ControlandoEletrons/TigardBR/TigardBR/3. Assets/1745753068074.jpg

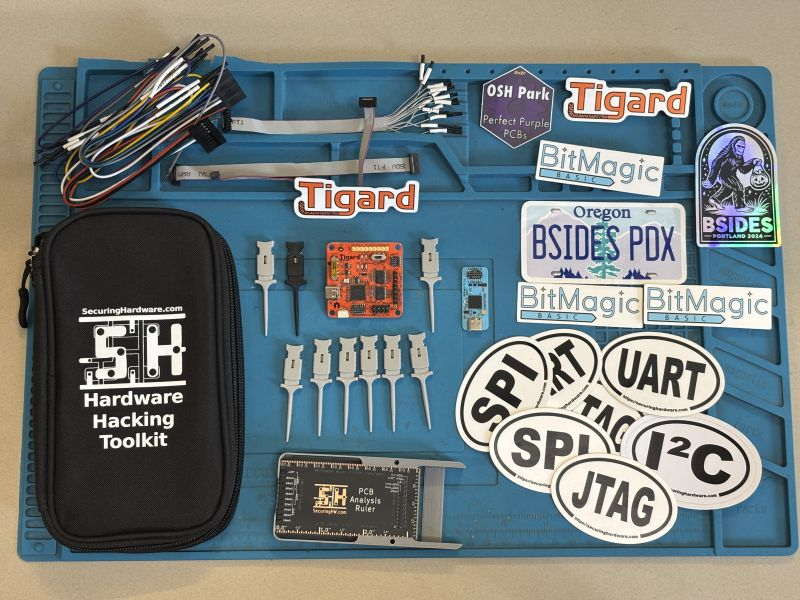
TigardBR/3. Assets/1745753068074.jpg
