ControlandoEletrons/TigardBR/TigardBR/3. Assets/Gi0Y8tjaMAABM5-.jpg

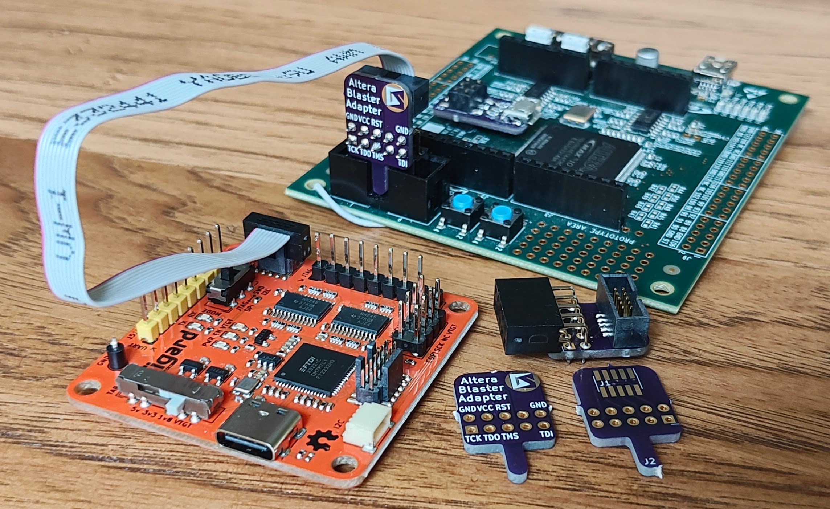
TigardBR/3. Assets/Gi0Y8tjaMAABM5-.jpg
