ControlandoEletrons/TigardBR/TigardBR/3. Assets/signaloid-external-illustration-Tigard-connection-diagram-withCR.png

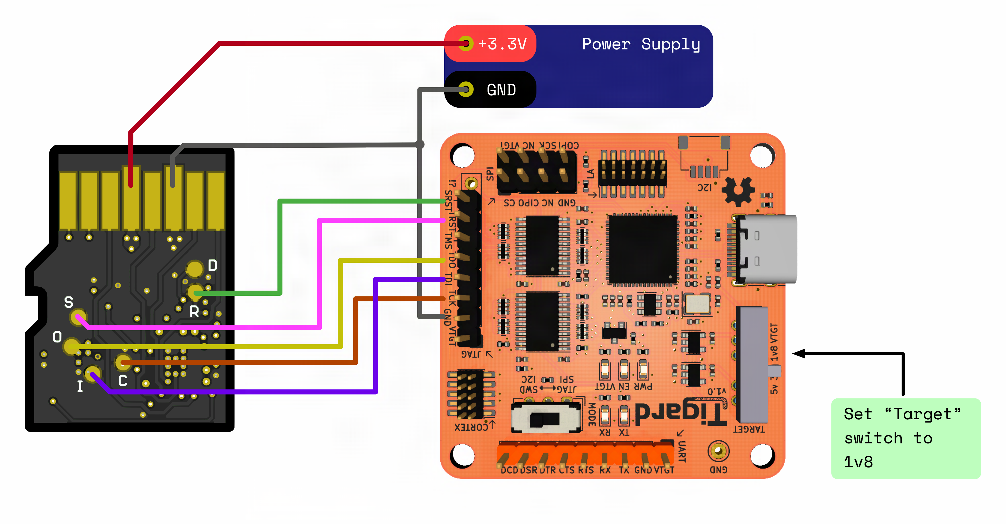
TigardBR/3. Assets/signaloid-external-illustration-Tigard-connection-diagram-withCR.png
