ControlandoEletrons/TigardBR/TigardBR/3. Assets/tigard-back.png

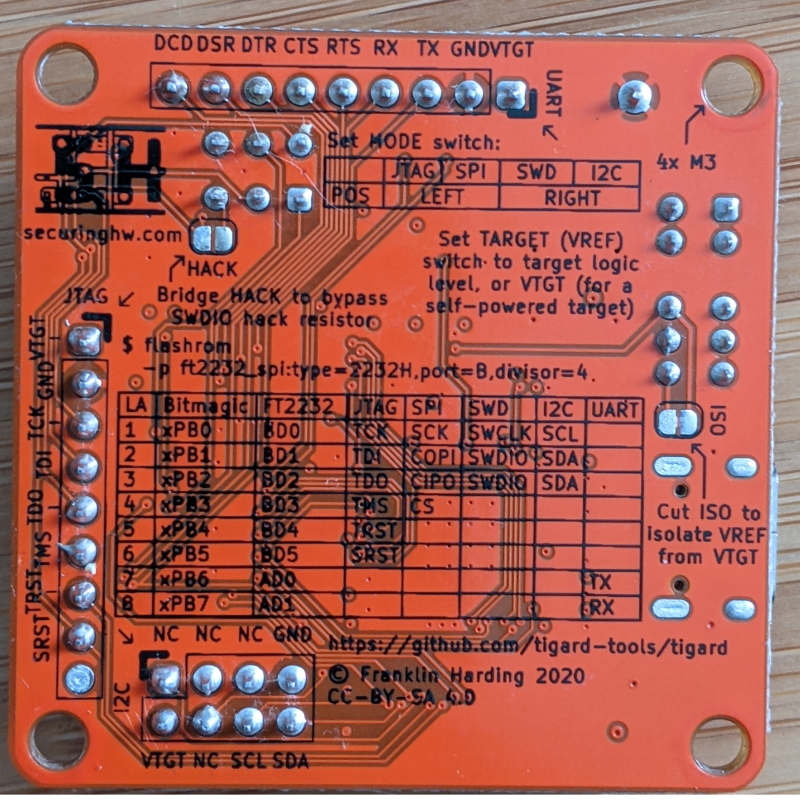
TigardBR/3. Assets/tigard-back.png
