ControlandoEletrons/TigardBR/TigardBR/3. Assets/Tigard-case-141341_002a.jpg

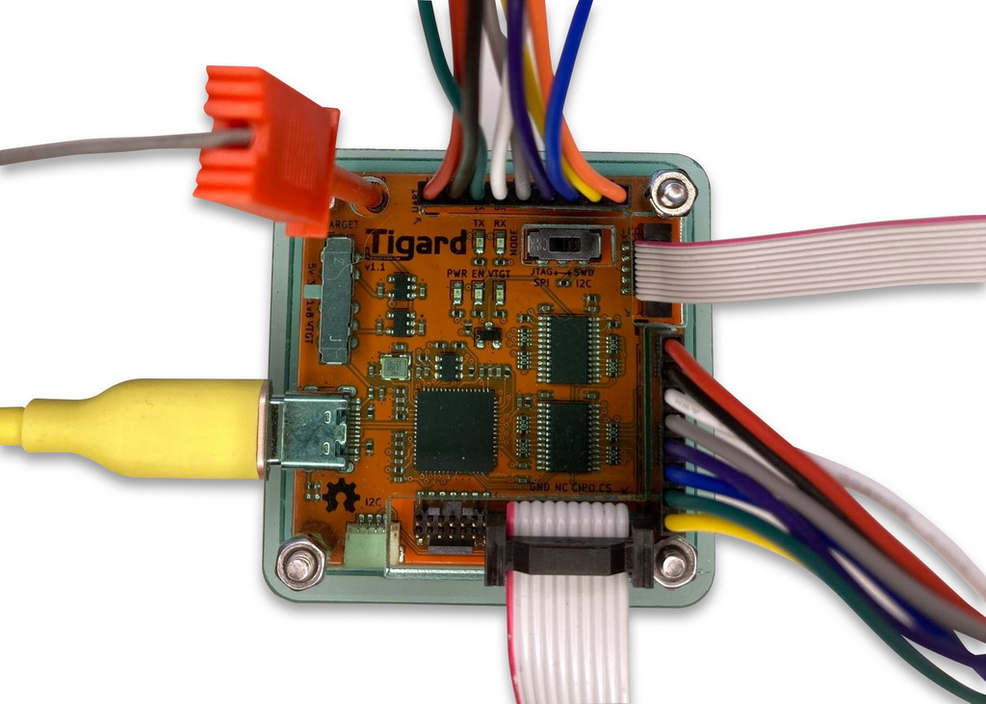
TigardBR/3. Assets/Tigard-case-141341_002a.jpg
