ControlandoEletrons/TigardBR/TigardBR/3. Assets/tigard-front.png

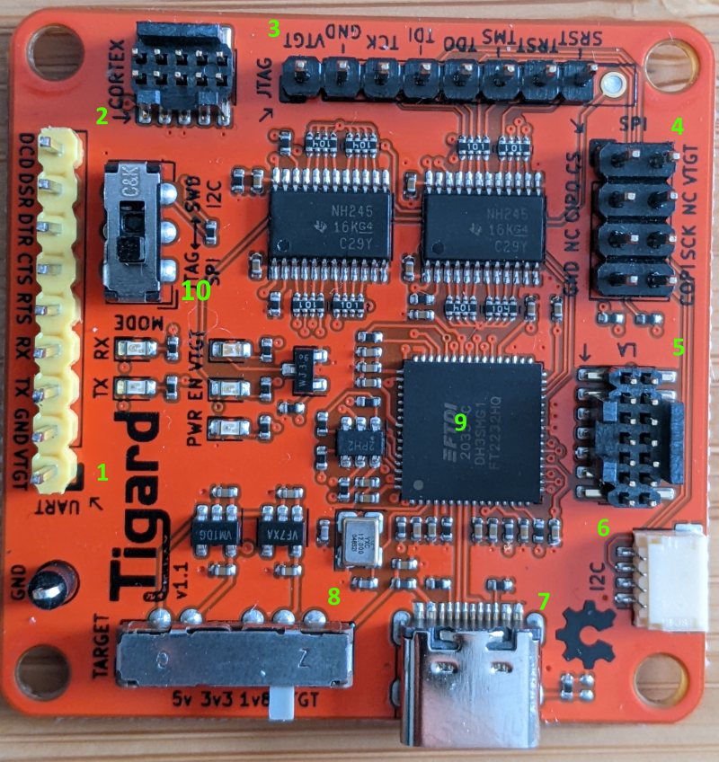
TigardBR/3. Assets/tigard-front.png
