ControlandoEletrons/TigardBR/Tigard/2. Datasheets/Slider Switch/3D Model/SSSS224100.STEP

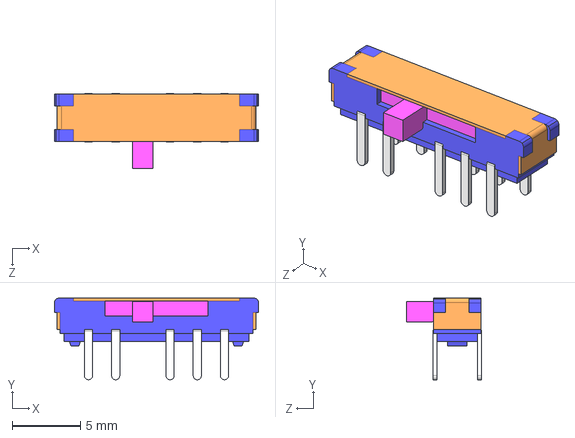
[picture p8: CAD file, 2026-01-16]
Tigard/2. Datasheets/Slider Switch/3D Model/SSSS224100.STEP
15.0 x 6.00 x 5.55 mm
