ControlandoEletrons/TigardBR/Tigard/0. Project/tigard.pdf

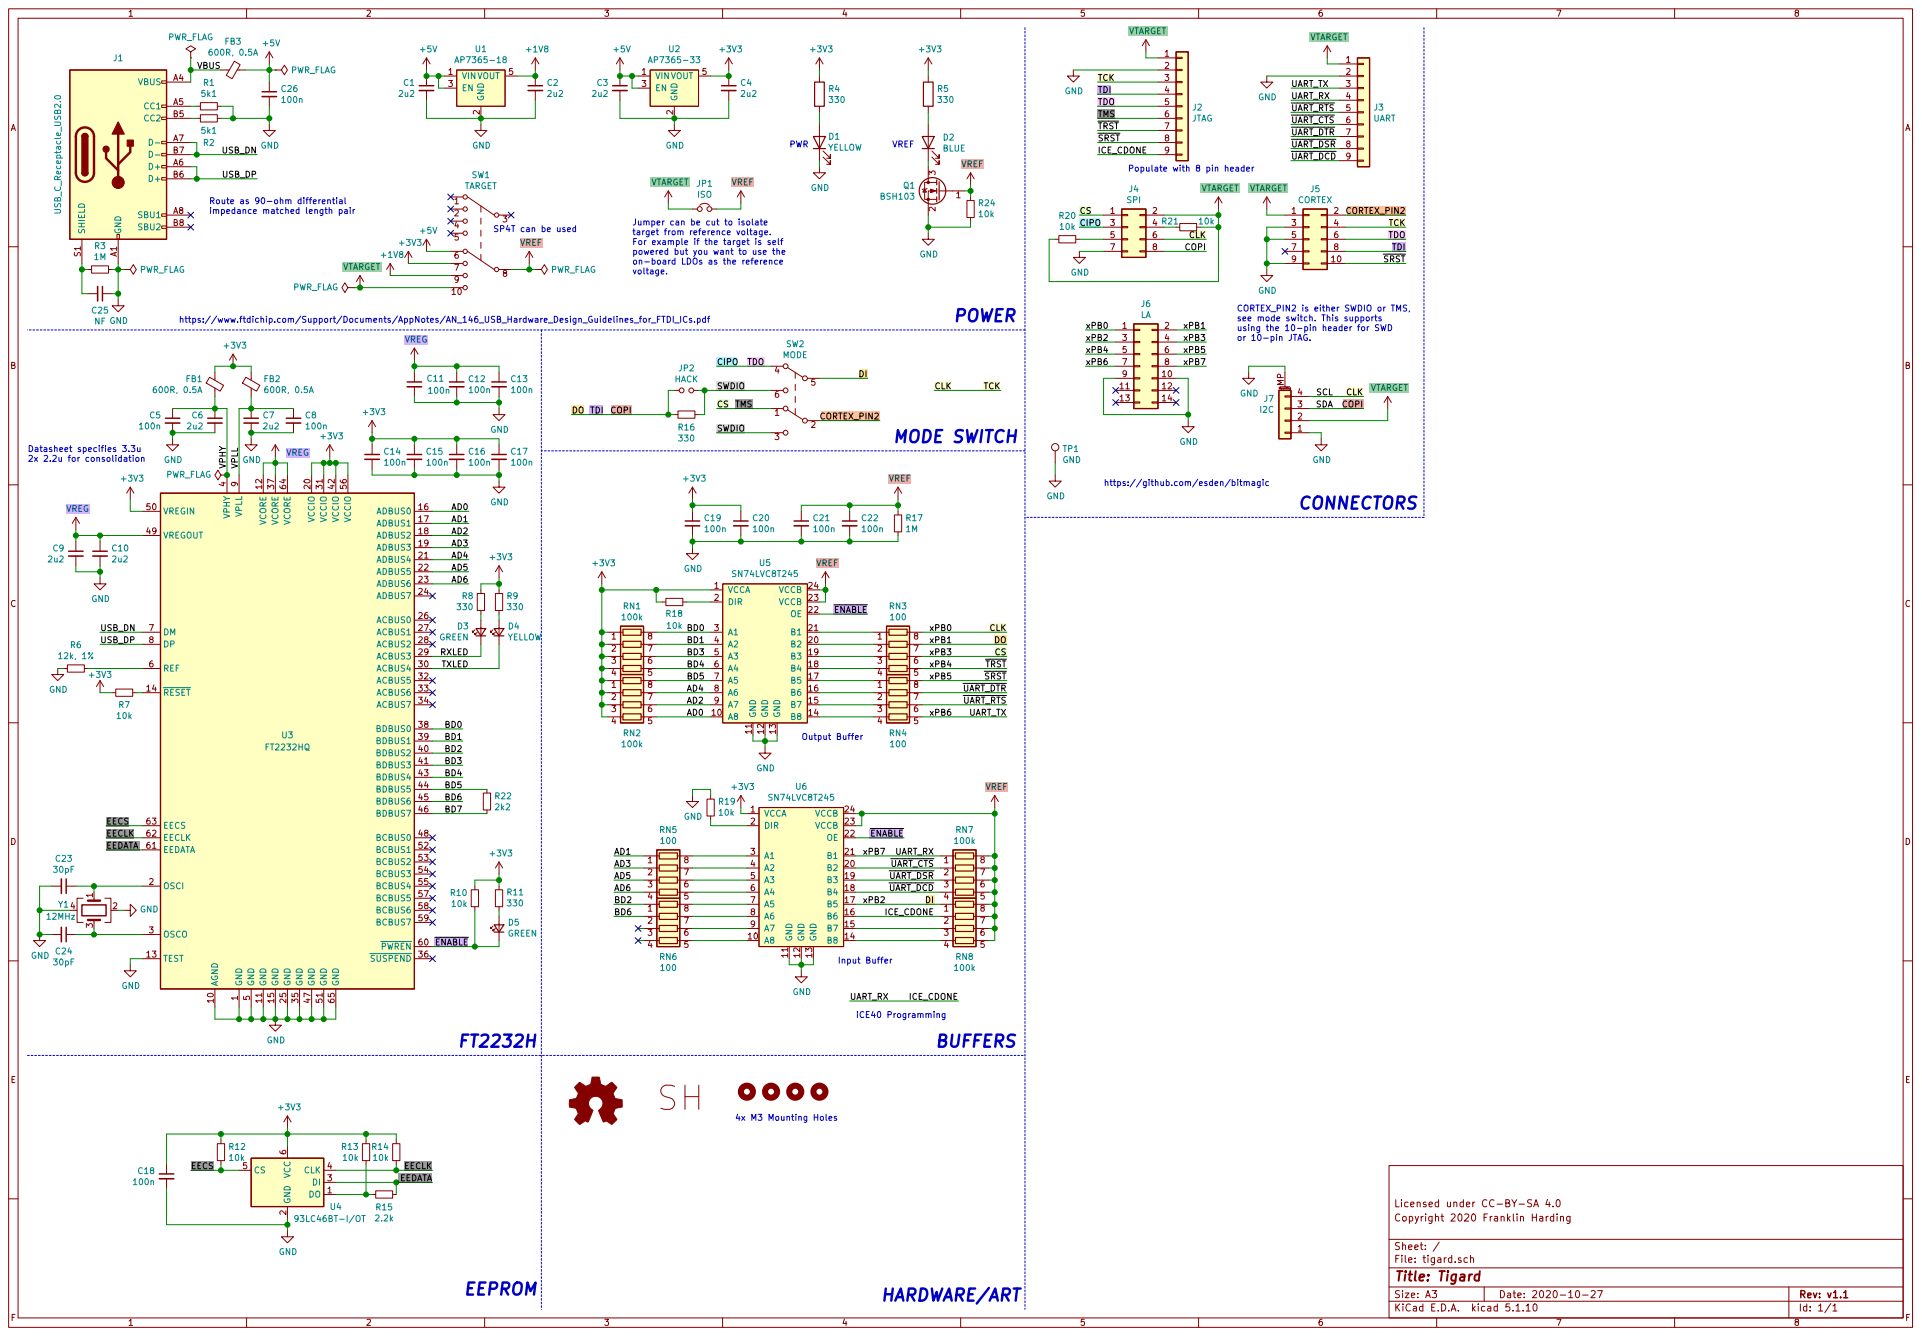
[picture p9: page 1]

Populate with 8 pin header

SP4T can be used Route as 90-ohm differential
impedance matched length pair
10k GND

Jumper can be cut to isolate
target from reference voltage.
For example if the target is self
powered but you want to use the
on-board LDOs as the reference

5 | 6 TDO
7 | 8 TDI SRST

GND
CORTEX_PIN2 is either SWDIO or TMS, see mode switch. This supports

https://www.ftdichip.com/Support/Documents/AppNotes/AN_146_USB_Hardware_Design_Guidelines_for_FTDI_ICs.pdf

using the 10-pin header for SWD
or 10-pin JTAG.

https://github.com/esden/bitmagic

1 AGND 10 GND 11 VCORE 12 TEST 13 RESET 14 GND 15 ADBUS0 16 ADBUS1 17 ADBUS2 18 ADBUS3 19 OSCI 2 VCCIO 20 ADBUS4 21 ADBUS5 22 ADBUS6 23 ADBUS7 24 GND 25 ACBUS0 26 ACBUS1 27 ACBUS2 28 ACBUS3 29 OSCO 3 ACBUS4 30 VCCIO 31 ACBUS5 32 ACBUS6 33 ACBUS7 34 GND 35 SUSPEND 36 VCORE 37 BDBUS0 38 BDBUS1 39 VPHY

4 BDBUS2 40 BDBUS3 41 VCCIO 42 BDBUS4 43 BDBUS5 44 BDBUS6 45 BDBUS7 46 GND 47 BCBUS0 48 VREGOUT 49 GND

5 VREGIN 50 GND 51 BCBUS1 52 BCBUS2 53 BCBUS3 54 BCBUS4 55 VCCIO 56 BCBUS5 57 BCBUS6 58 BCBUS7 59 REF 6 PWREN 60 EEDATA 61 EECLK 62 EECS 63 VCORE 64 GND 65 DM 7 DP 8 VPLL

2 DI 3 CLK 4 CS 5 VCC

Licensed under CC-BY-SA 4.0
File: tigard.sch Sheet: / Copyright 2020 Franklin Harding
