ControlandoEletrons/TigardBR/TigardBR/0. Project/TigardBR.sch

## EAGLE design TigardBR/0. Project/TigardBR.sch (2026-01-29)

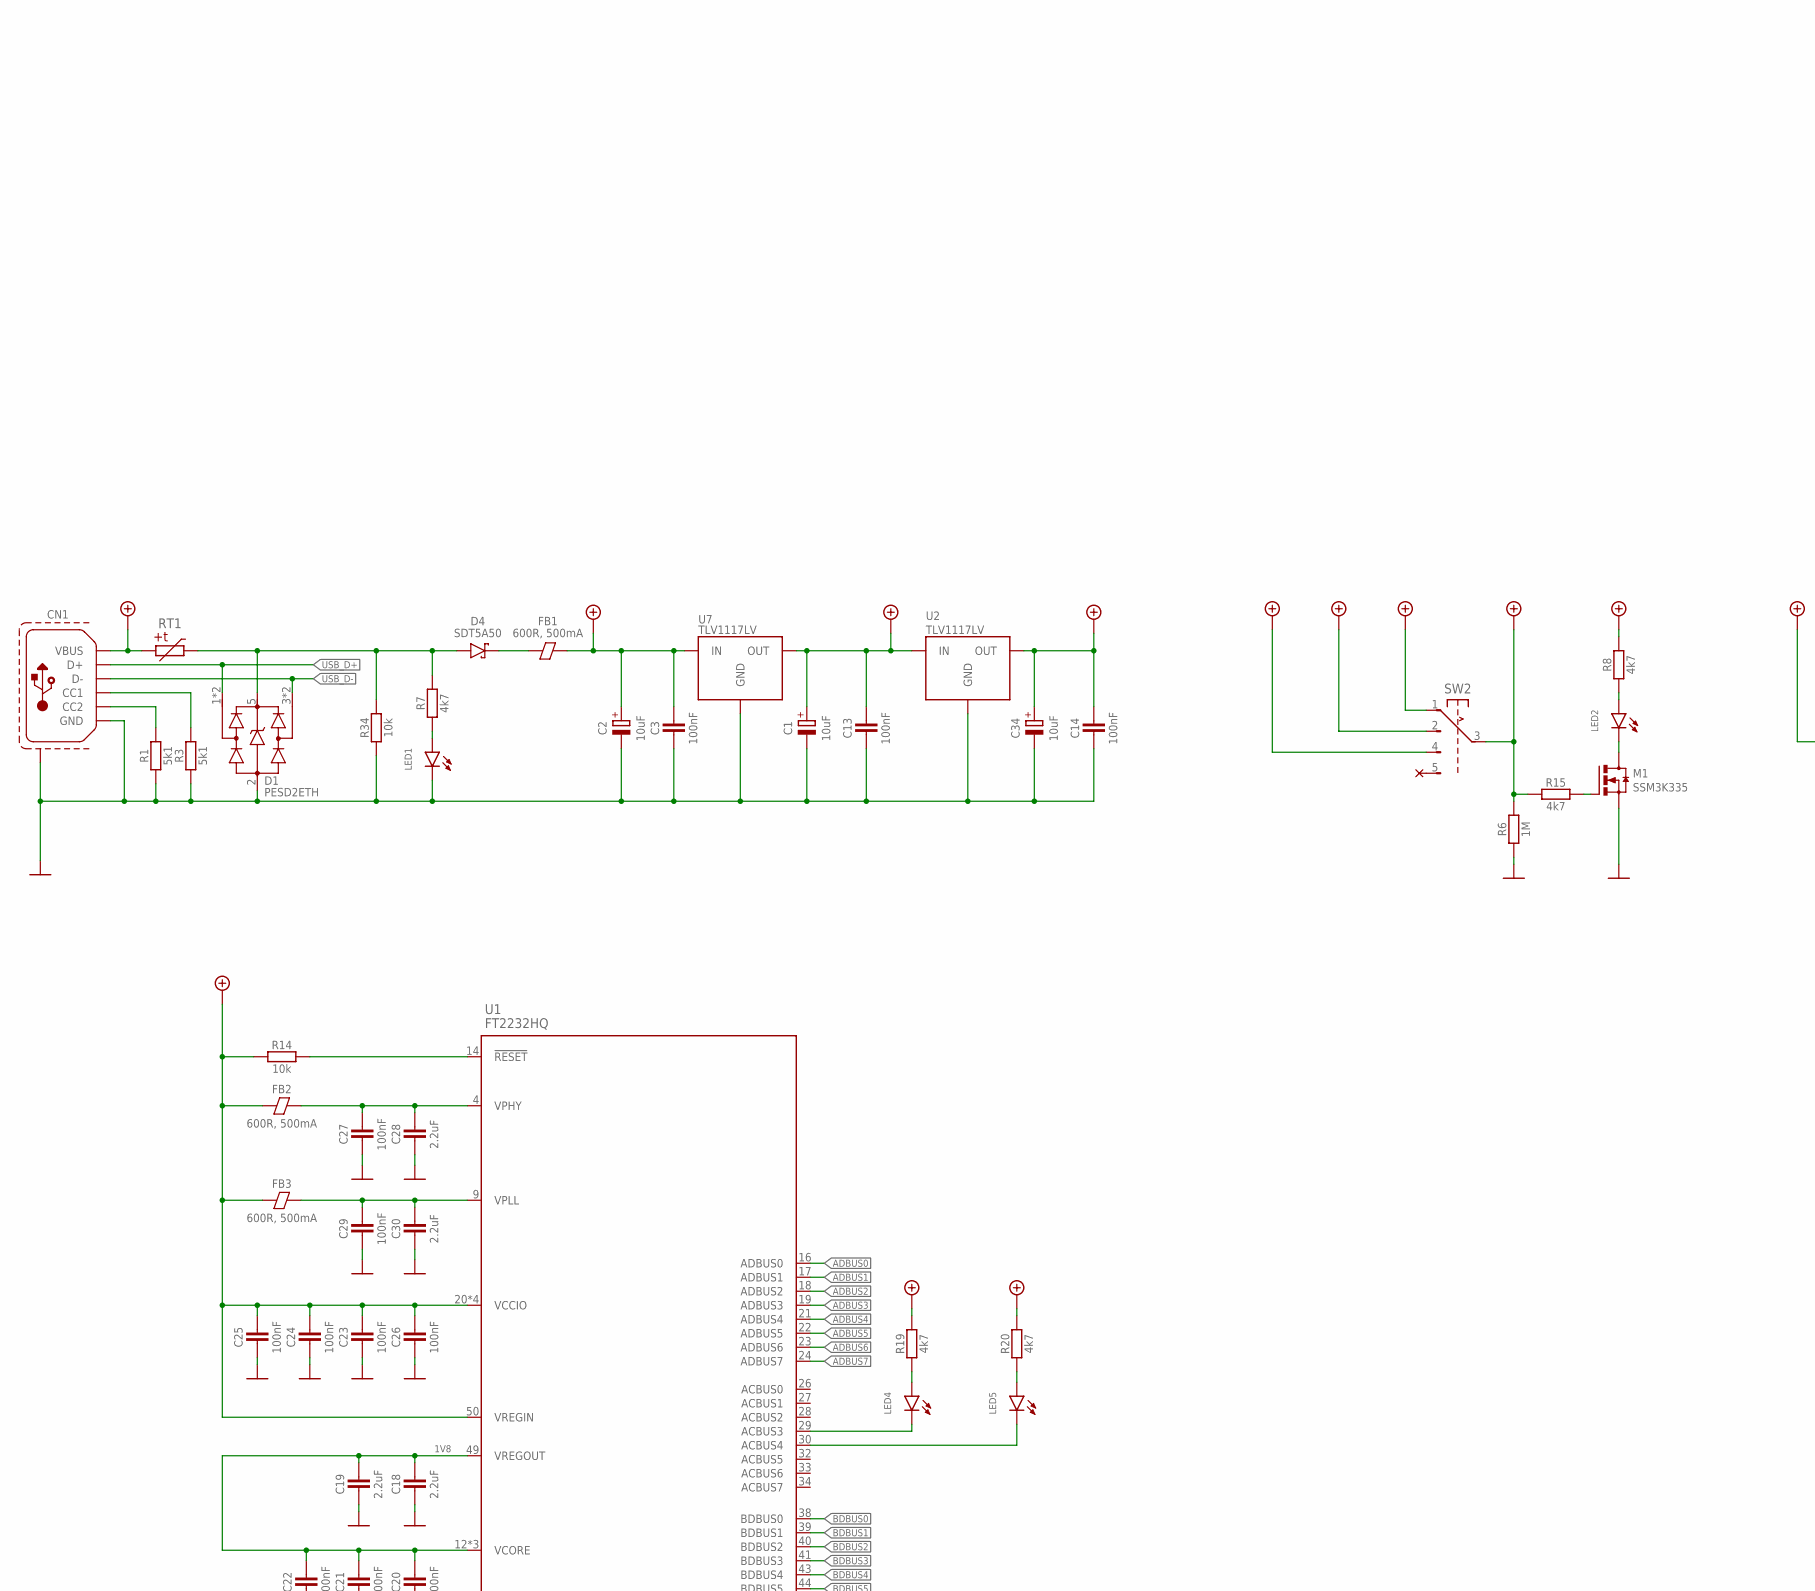
[picture p13: schematic TigardBR.sch, part in row 1, column 1]

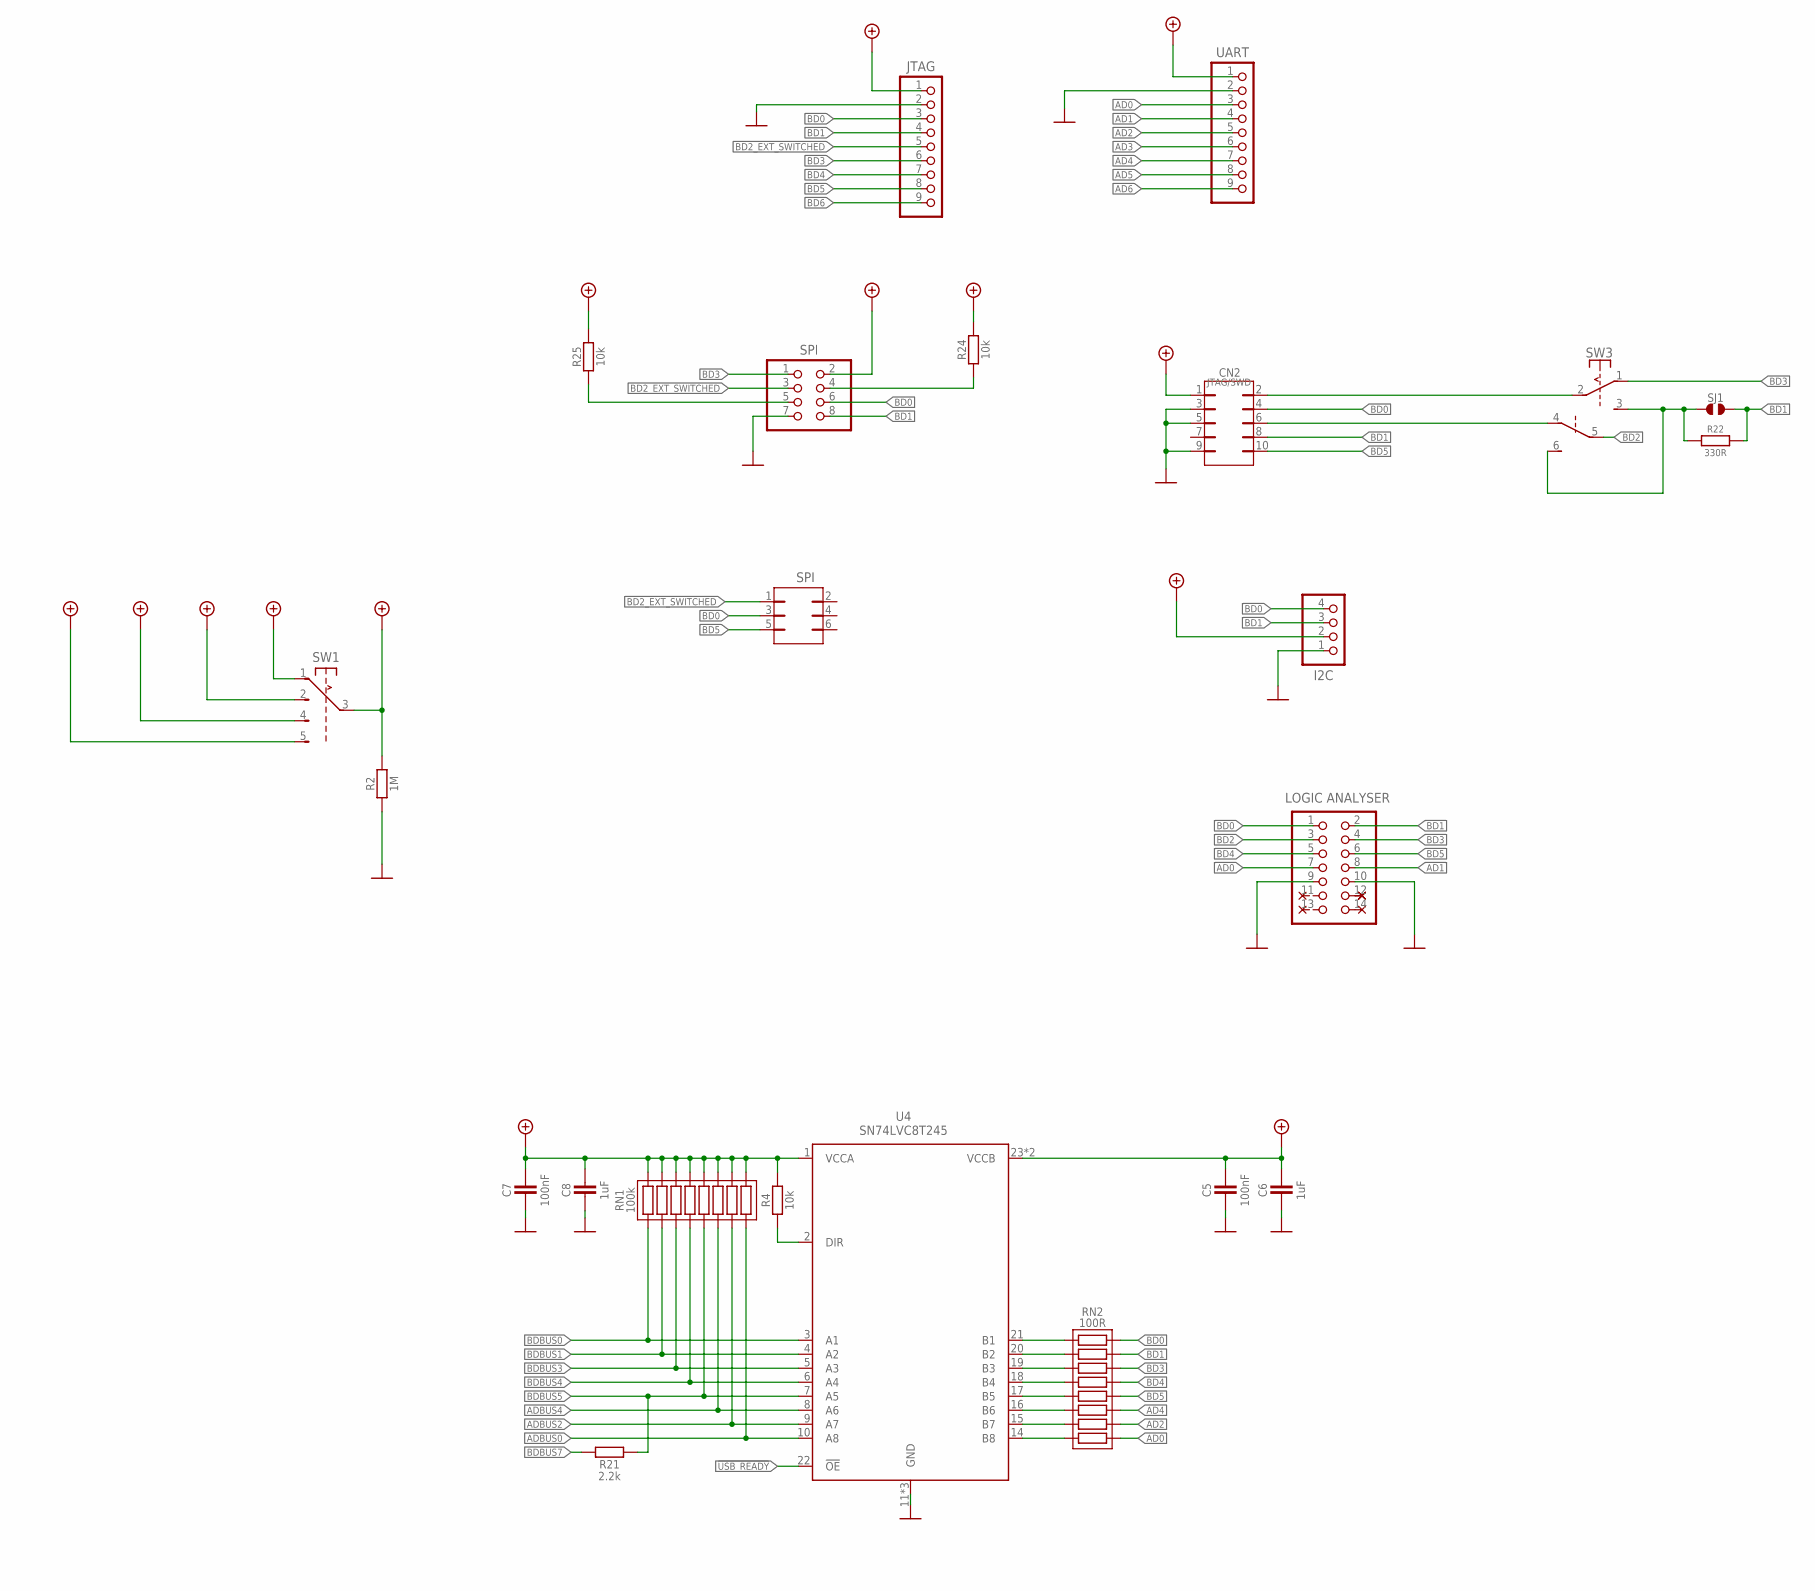
[picture p14: schematic TigardBR.sch, part in row 1, column 2]

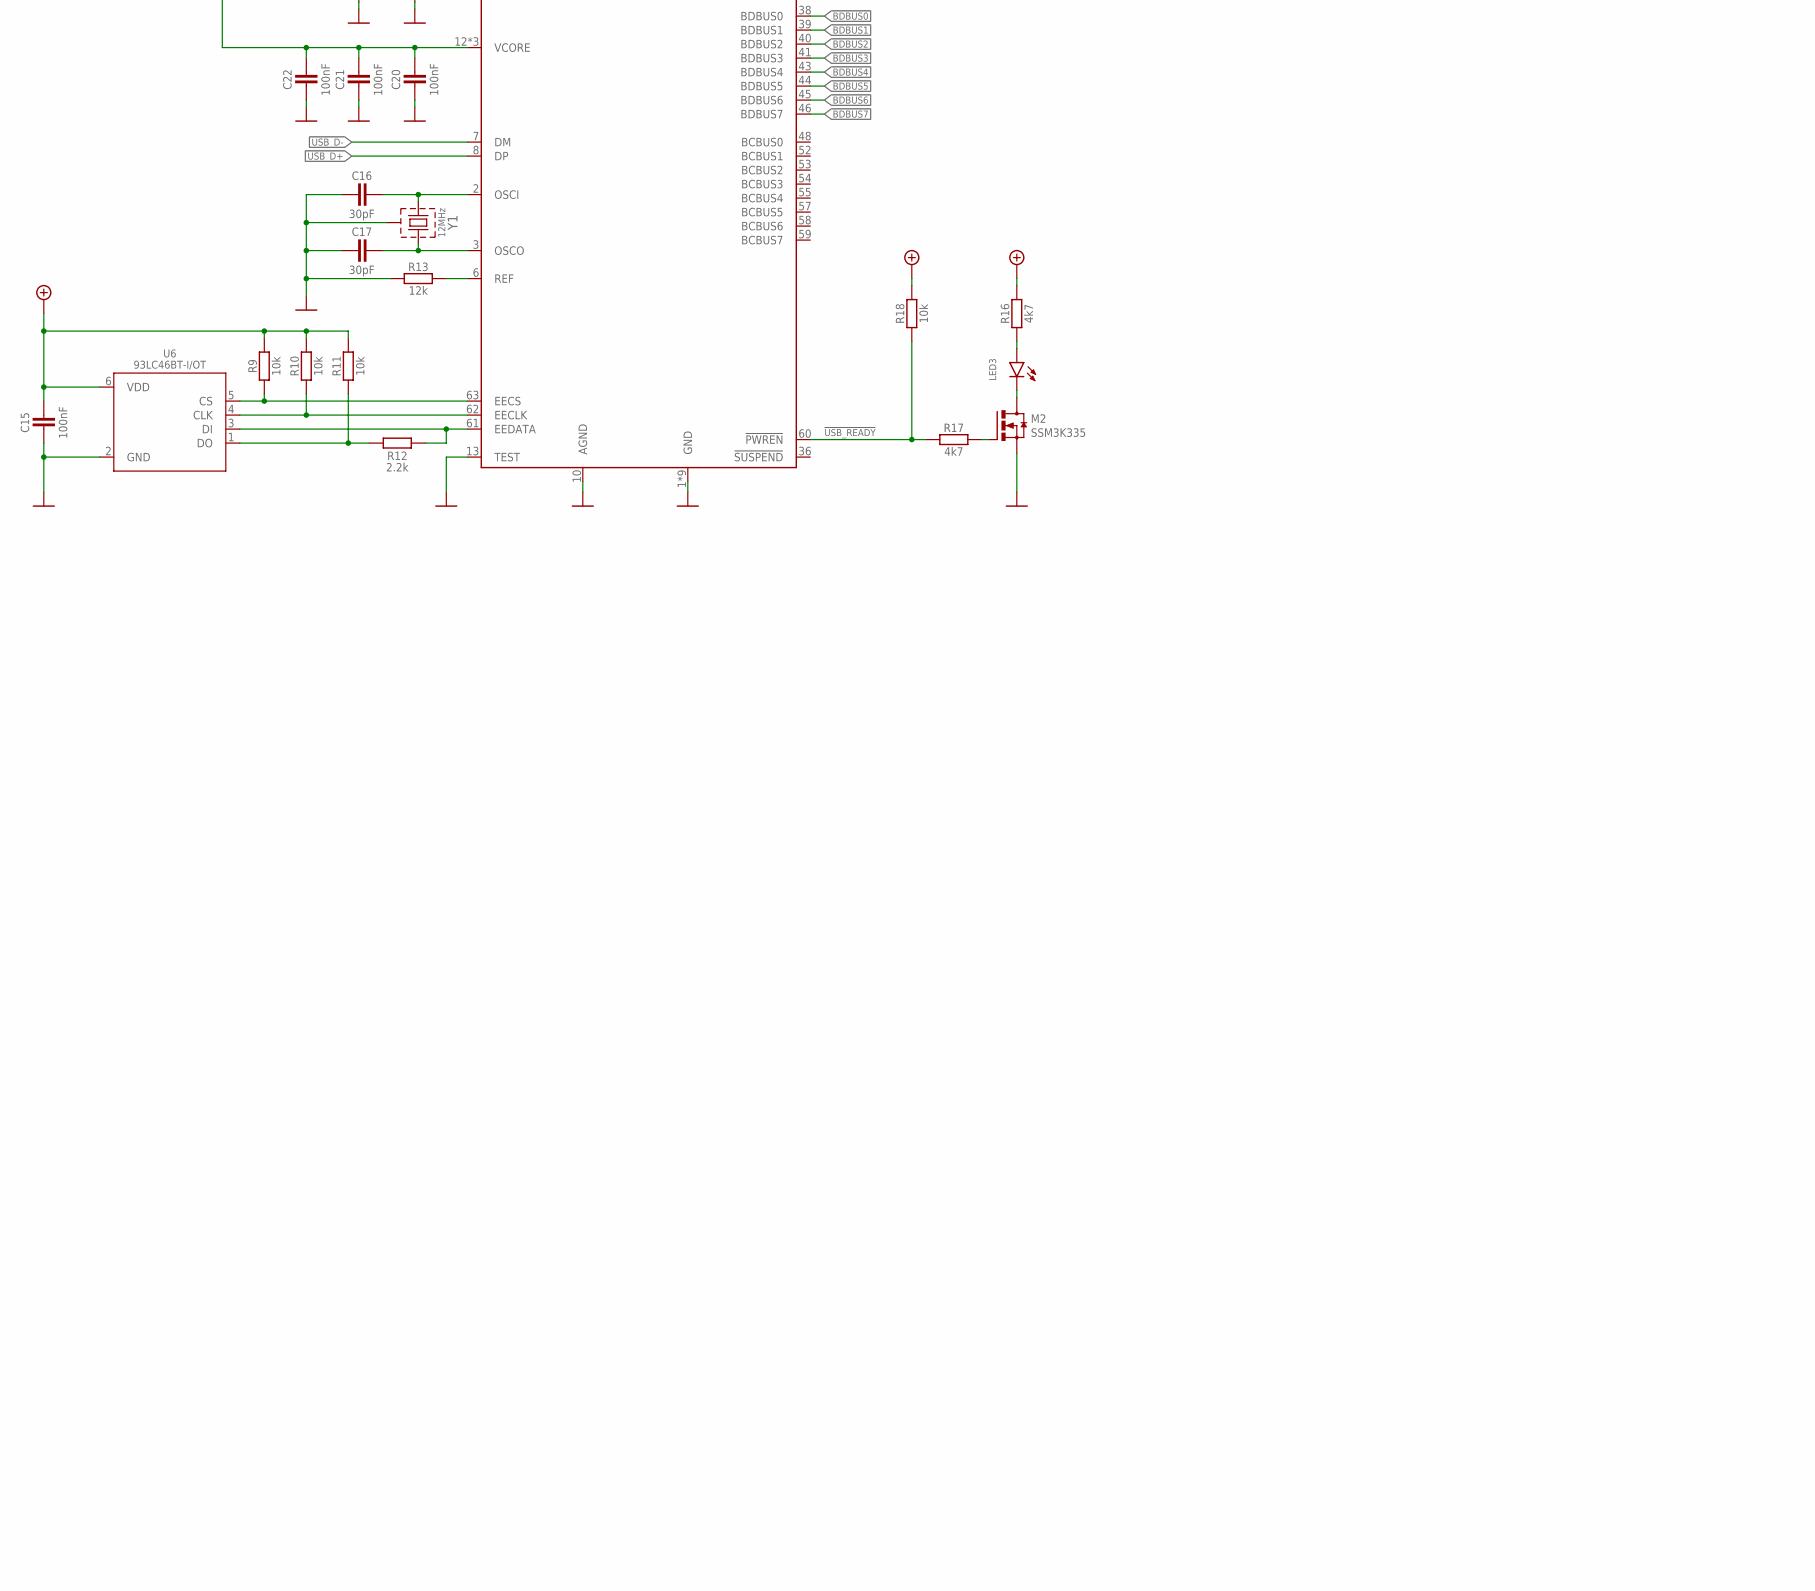
[picture p15: schematic TigardBR.sch, part in row 2, column 1]

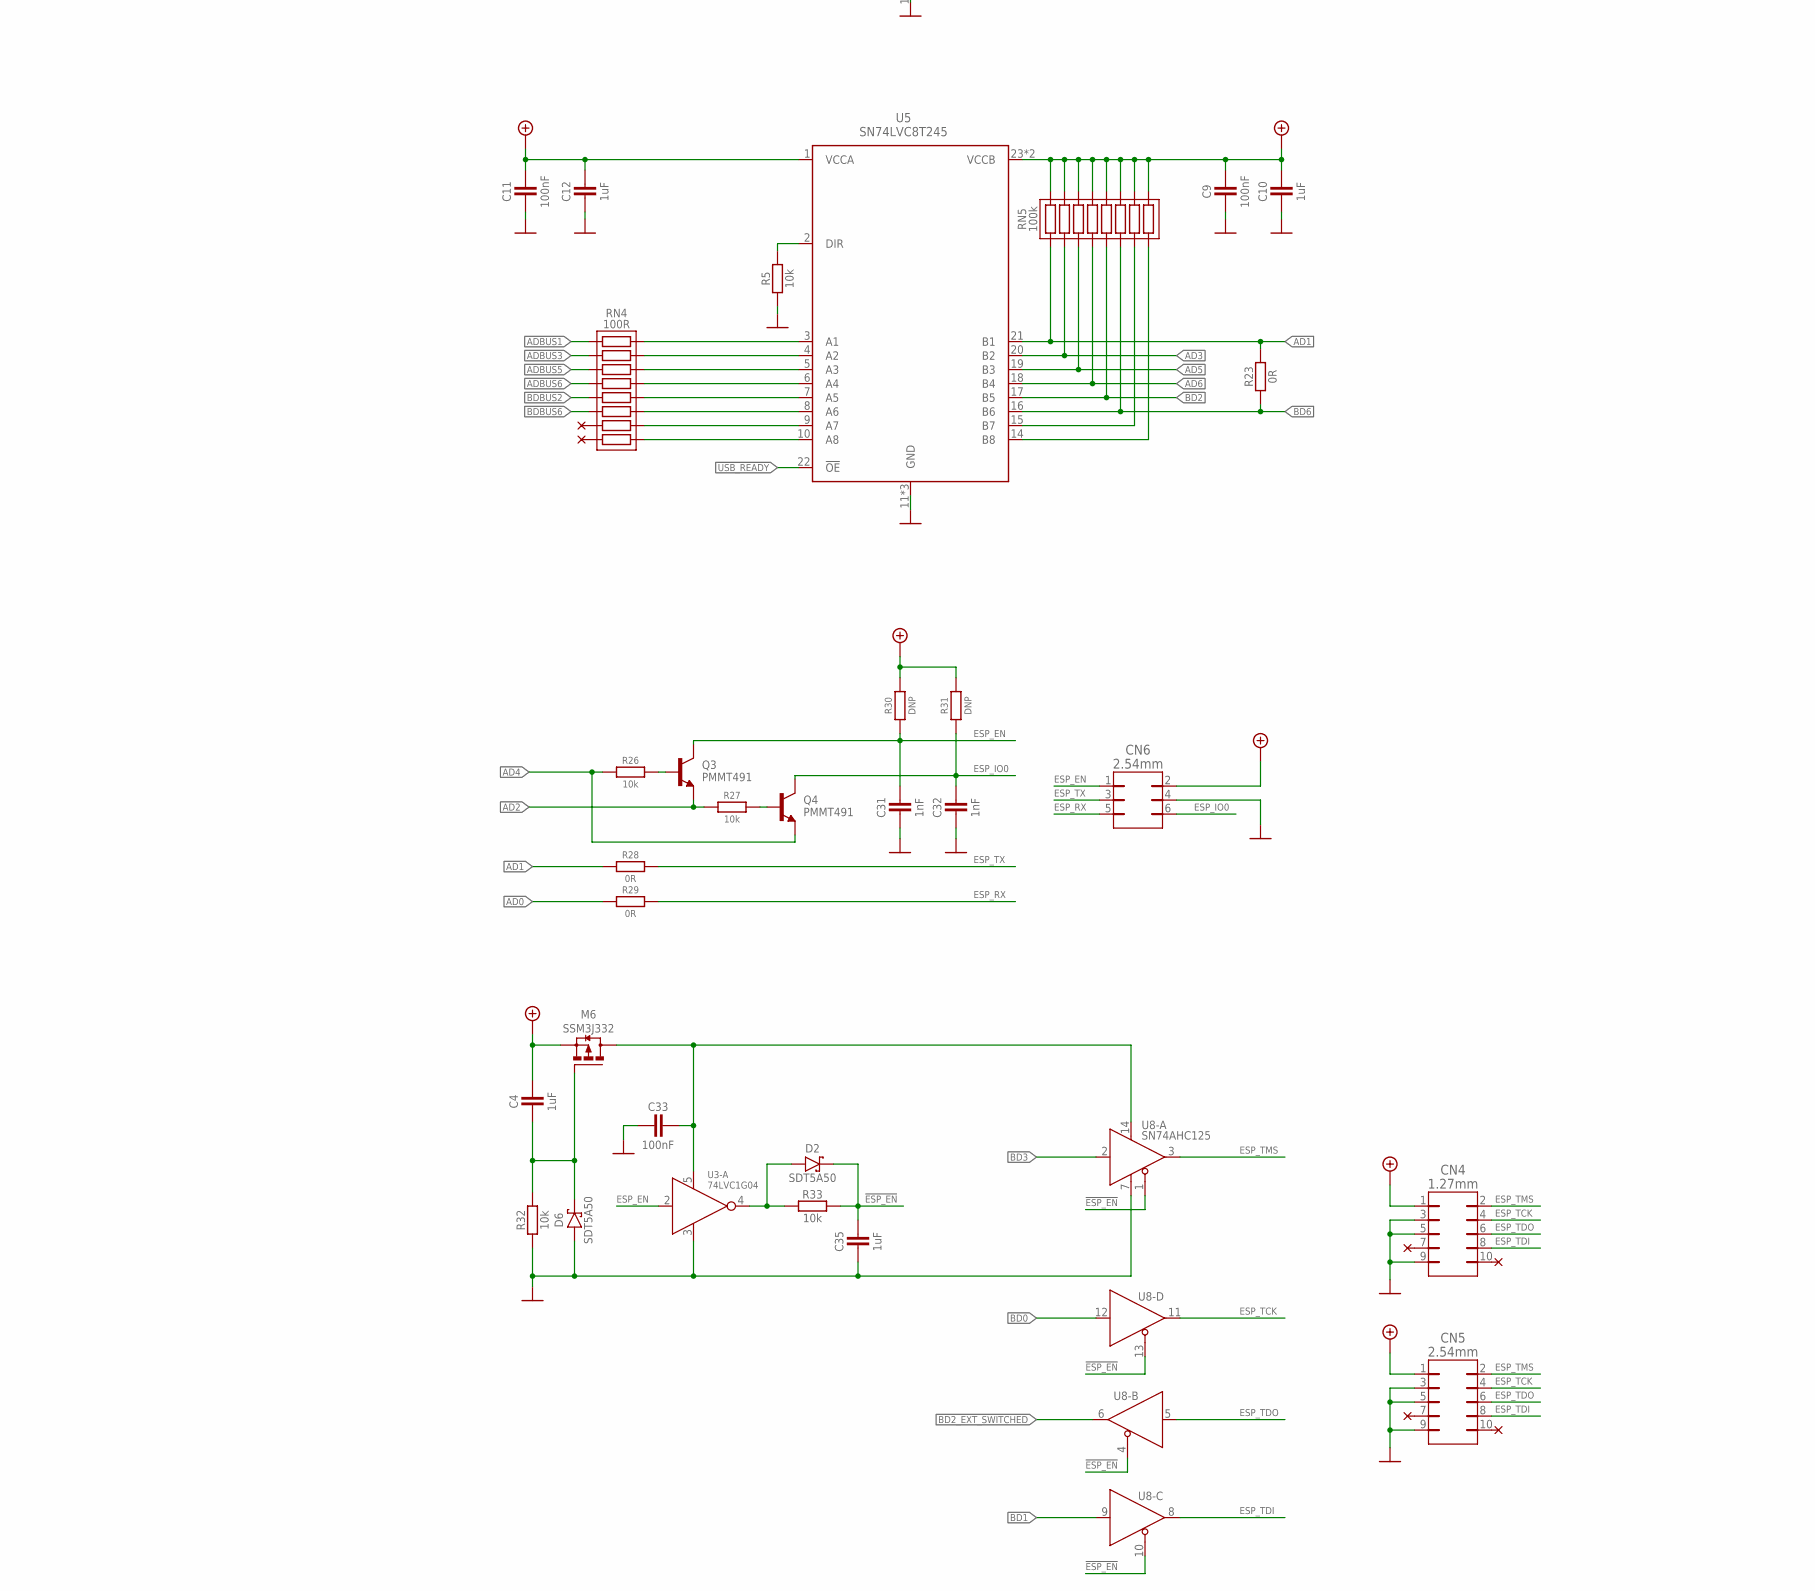
[picture p16: schematic TigardBR.sch, part in row 2, column 2]

Parts:
C1, C2, C34: 10uF; C1206_POL
C3, C5, C7, C9, C11, C13, C14, C15, C20, C21, C22, C23, C24, C25, C26, C27, C29, C33: 100nF; C0603
C4, C6, C8, C10, C12, C35: 1uF; C0603
C16, C17: 30pF; C0603
C18, C19, C28, C30: 2.2uF; C0603
C31, C32: 1nF; C0603
CN1: USB-C-16P
CN2: JTAG/SWD; JTAG-ARM-10P
CN3: I2C; 1X04
CN4: 1.27mm; JTAG-ARM-10P
CN5: 2.54mm; 2X05
CN6: 2.54mm; 2X03
D1: TVS-ARRAY-2; TSOP-6
D2, D4, D6: SDT5A50; DO-214AC
FB1, FB2, FB3: 600R, 500mA; L0603
JP1: JTAG; 1X09
JP2: SPI; 2X04
JP3: UART; 1X09
JP4: LOGIC ANALYSER; 2X07
JP5: SPI; 2X03
LED1: GREEN; L0603G
LED2: BLUE; L0603B
LED3: RED; L0603R
LED4, LED5: YELLOW; L0603Y
M1, M2: SSM3K335; SOT23-3
M6: SSM3J332; SOT23-3
Q3, Q4: PMMT491; SOT23-3
R1, R3: 5k1; R0603
R2, R6: 1M; R0603
R4, R5, R9, R10, R11, R14, R18, R24, R25, R26, R27, R32, R33, R34: 10k; R0603
R7, R8, R15, R16, R17, R19, R20: 4k7; R0603
R12, R21: 2.2k; R0603
R13: 12k; R0603
R22: 330R; R0603
R23, R28, R29: 0R; R0603
R30, R31: DNP; R0603
RN1, RN5: 100k; RN0602
RN2, RN4: 100R; RN0602
RT1: PTC-; F1812
SJ1: 2P-NO; 2P-NO-0603
SW1, SW2: DP4T-; SSSS224100
SW3: DP2T-STRAIGHT-SMD; JS202011SCQN
U1: FT2232HQ; QFN-64
U2, U7: TLV1117LV; SOT-223-3
U3: 74LVC1G04; SOT753-5_(SC-74A)
U4, U5: SN74LVC8T245; TSSOP-24
U6: 93LC46BT-I/OT; SOT23-6
U8: SN74AHC125; SOIC-14
Y1: 12MHz; 3.2MM_2.5MM

Connections:
0V: C1.2 (-), C2.2 (-), C3.2, C5.2, C6.2, C7.2, C8.2, C9.2, C10.2, C11.2, C12.2, C13.2, C14.2, C15.2, C16.2, C17.2, C18.2, C19.2, C20.2, C21.2, C22.2, C23.2, C24.2, C25.2, C26.2, C27.2, C28.2, C29.2, C30.2, C31.2, C32.2, C33.2, C34.2 (-), C35.2, CN1.A1_B12 (GND), CN1.S1 (CHASSI), CN2.3 (GND), CN2.5 (GND2), CN2.9 (GND3), CN3.1, CN4.3 (GND), CN4.5 (GND2), CN4.9 (GND3), CN5.3, CN5.5, CN5.9, CN6.4, D1.2 (GND), D6.2 (A), JP1.2, JP2.7, JP3.2, JP4.9, JP4.10, LED1.K, M1.2 (S), M2.2 (S), R1.1, R2.1, R3.1, R5.2, R6.1, R13.2, R32.1, R34.1, U1.1 (GND), U1.10 (AGND), U1.13 (TEST), U2.1 (GND), U3.3 (VSS), U4.11 (GND), U5.11 (GND), U6.2 (GND), U7.1 (GND), U8.7 (VSS), Y1.2 (CH)
1.8V: C14.1, C34.1 (+), SW1.4 (NO2), SW2.4 (NO2), U2.2 (OUT)
1V8: C18.1, C19.1, C20.1, C21.1, C22.1, U1.12 (VCORE), U1.49 (VREGOUT)
3.3V: C1.1 (+), C7.1, C8.1, C11.1, C12.1, C13.1, C15.1, C23.1, C24.1, C25.1, C26.1, FB2.1, FB3.1, R4.1, R8.2, R9.1, R10.1, R11.1, R14.2, R16.2, R18.1, R19.2, R20.2, RN1.1, RN1.2, RN1.3, RN1.4, RN1.5, RN1.6, RN1.7, RN1.8, SW1.2 (NO1), SW2.2 (NO1), U1.20 (VCCIO), U1.50 (VREGIN), U2.3 (IN), U4.1 (VCCA), U5.1 (VCCA), U6.6 (VDD), U7.2 (OUT)
5.0V: C2.1 (+), C3.1, FB1.2, SW1.1 (NC), SW2.1 (NC), U7.3 (IN)
!ESP_EN: C35.1, D2.1 (K), R33.2, U8.1 (!OE), U8.4 (!OE), U8.10 (!OE), U8.13 (!OE)
!USB_READY: R17.1, R18.2, U1.60 (!PWREN), U4.22 (!OE), U5.22 (!OE)
AD0: JP3.3, JP4.7, R29.1, RN2.9
AD1: JP3.4, JP4.8, R23.1, R28.1, RN5.16, U5.21 (B1)
AD2: JP3.5, Q3.2 (E), R27.1, RN2.10
AD3: JP3.6, RN5.15, U5.20 (B2)
AD4: JP3.7, Q4.2 (E), R26.1, RN2.11
AD5: JP3.8, RN5.14, U5.19 (B3)
AD6: JP3.9, RN5.13, U5.18 (B4)
ADBUS0: RN1.9, RN5.9, U1.16 (ADBUS0), U4.10 (A8), U5.14 (B8)
ADBUS1: RN4.1, U1.17 (ADBUS1)
ADBUS2: RN1.10, RN5.10, U1.18 (ADBUS2), U4.9 (A7), U5.15 (B7)
ADBUS3: RN4.2, U1.19 (ADBUS3)
ADBUS4: RN1.11, U1.21 (ADBUS4), U4.8 (A6)
ADBUS5: RN4.3, U1.22 (ADBUS5)
ADBUS6: RN4.4, U1.23 (ADBUS6)
ADBUS7: U1.24 (ADBUS7)
BD0: CN2.4 (TCK), CN3.4, JP1.3, JP2.6, JP4.1, JP5.3, RN2.16, U8.12 (A)
BD1: CN2.8 (TDI), CN3.3, JP1.4, JP2.8, JP4.2, R22.2, RN2.15, SJ1.2 (3), U8.9 (A)
BD2: JP4.3, RN5.12, SW3.5 (C), U5.17 (B5)
BD2_EXT_SWITCHED: CN2.6 (TDO), JP1.5, JP2.3, JP5.1, SW3.4 (NC), U8.6 (Y)
BD3: JP1.6, JP2.1, JP4.4, RN2.14, SW3.1 (NC), U8.2 (A)
BD4: JP1.7, JP4.5, RN2.13
BD5: CN2.10 (!RST), JP1.8, JP4.6, JP5.5, RN2.12
BD6: JP1.9, R23.2, RN5.11, U5.16 (B6)
BDBUS0: RN1.16, U1.38 (BDBUS0), U4.3 (A1)
BDBUS1: RN1.15, U1.39 (BDBUS1), U4.4 (A2)
BDBUS2: RN4.5, U1.40 (BDBUS2)
BDBUS3: RN1.14, U1.41 (BDBUS3), U4.5 (A3)
BDBUS4: RN1.13, U1.43 (BDBUS4), U4.6 (A4)
BDBUS5: R21.1, RN1.12, U1.44 (BDBUS5), U4.7 (A5)
BDBUS6: RN4.6, U1.45 (BDBUS6)
BDBUS7: R21.2, U1.46 (BDBUS7)
ESP_EN: C31.1, CN6.1, Q3.3 (C), R30.1, U3.2 (A)
ESP_IO0: C32.1, CN6.6, Q4.3 (C), R31.1
ESP_RX: CN6.5, R29.2
ESP_TCK: CN4.4 (TCK), CN5.4, U8.11 (Y)
ESP_TDI: CN4.8 (TDI), CN5.8, U8.8 (Y)
ESP_TDO: CN4.6 (TDO), CN5.6, U8.5 (A)
ESP_TMS: CN4.2 (TMS), CN5.2, U8.3 (Y)
ESP_TX: CN6.3, R28.2
unnamed: LED2.A, R8.1
unnamed: R4.2, U4.2 (DIR)
unnamed: R5.1, U5.2 (DIR)
unnamed: RN4.16, U5.3 (A1)
unnamed: RN4.15, U5.4 (A2)
unnamed: RN4.14, U5.5 (A3)
unnamed: D4.1 (K), FB1.1
unnamed: RN4.13, U5.6 (A4)
unnamed: RN4.12, U5.7 (A5)
unnamed: RN4.11, U5.8 (A6)
unnamed: RN4.10, U5.9 (A7)
unnamed: RN2.1, U4.21 (B1)
unnamed: RN2.2, U4.20 (B2)
unnamed: RN2.3, U4.19 (B3)
unnamed: RN2.4, U4.18 (B4)
unnamed: RN2.5, U4.17 (B5)
unnamed: RN2.6, U4.16 (B6)
unnamed: RN2.7, U4.15 (B7)
unnamed: RN2.8, U4.14 (B8)
unnamed: LED2.K, M1.3 (D)
unnamed: RN4.9, U5.10 (A8)
unnamed: R9.2, U1.63 (EECS), U6.5 (CS)
unnamed: R10.2, U1.62 (EECLK), U6.4 (CLK)
unnamed: R11.2, R12.2, U6.1 (DO)
unnamed: R12.1, U1.61 (EEDATA), U6.3 (DI)
unnamed: LED1.A, R7.1
unnamed: C16.1, U1.2 (OSCI), Y1.1 (IN)
unnamed: C17.1, U1.3 (OSCO), Y1.3 (OUT)
unnamed: R13.1, U1.6 (REF)
unnamed: R14.1, U1.14 (!RESET)
unnamed: C27.1, C28.1, FB2.2, U1.4 (VPHY)
unnamed: C29.1, C30.1, FB3.2, U1.9 (VPLL)
unnamed: M1.1 (G), R15.2
unnamed: LED3.A, R16.1
unnamed: LED3.K, M2.3 (D)
unnamed: M2.1 (G), R17.2
unnamed: LED4.A, R19.1
unnamed: LED4.K, U1.29 (ACBUS3)
unnamed: CN1.A5 (CC1), R3.2
unnamed: CN1.B5 (CC2), R1.2
unnamed: LED5.K, U1.30 (ACBUS4)
unnamed: LED5.A, R20.1
unnamed: CN2.2 (TMS), SW3.2 (C)
unnamed: JP2.4, R24.1
unnamed: JP2.5, R25.1
unnamed: Q3.1 (B), R26.2
unnamed: Q4.1 (B), R27.2
unnamed: D1.5 (VCC), D4.2 (A), R7.2, R34.2, RT1.1
unnamed: C4.2, D6.1 (K), M6.1 (G), R32.2
unnamed: C33.1, M6.3 (D), U3.5 (VDD), U8.14 (VDD)
unnamed: D2.2 (A), R33.1, U3.4 (Y)
SWDIO: R22.1, SJ1.1, SW3.3 (NO), SW3.6 (NO)
USB_D+: CN1.A6 (D+), D1.1 (IO1), U1.8 (DP)
USB_D-: CN1.A7 (D-), D1.3 (IO2), U1.7 (DM)
VBUS: CN1.A4_B9 (VBUS), RT1.2
VLOGIC: C4.1, C5.1, C6.1, C9.1, C10.1, M6.2 (S), R2.2, R30.2, R31.2, RN5.1, RN5.2, RN5.3, RN5.4, RN5.5, RN5.6, RN5.7, RN5.8, SW1.3 (C), U4.23 (VCCB), U5.23 (VCCB)
VTARGET: CN2.1 (VDD), CN3.2, CN4.1 (VDD), CN5.1, CN6.2, JP1.1, JP2.2, JP3.1, R6.2, R15.1, R24.2, R25.2, SW1.5 (NO3), SW2.3 (C)
