ControlandoEletrons/TigardBR/(notices)

Notices in the files:
Tigard/0. Project/tigard.kicad_pcb:
Copyright Franklin Harding 2020
© Franklin Harding 2020
CC-BY-SA 4.0
parts and their libraries:
My-RLC: Copyright (C) 2007, Bob Starr
